Motunrayo321/AquaBot/20240624_151016.jpg

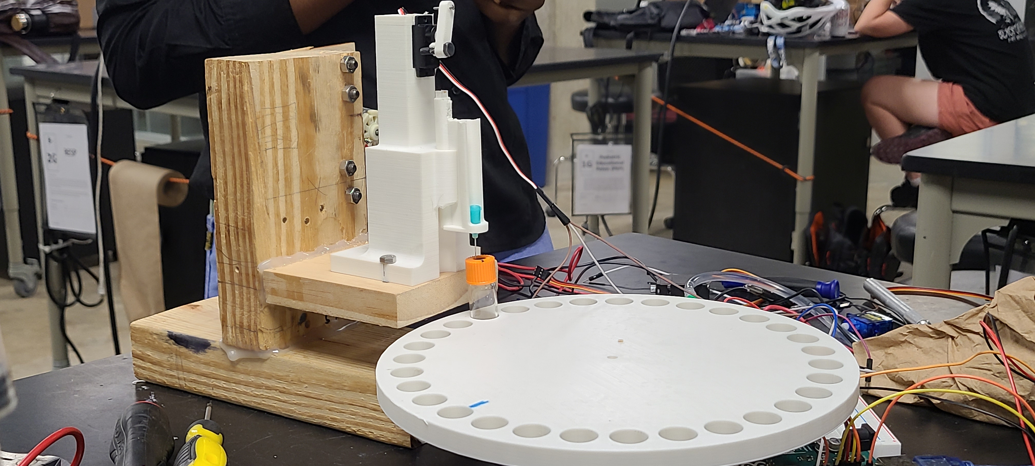
20240624_151016.jpg
