Motunrayo321/AquaBot/20240717_131111.jpg

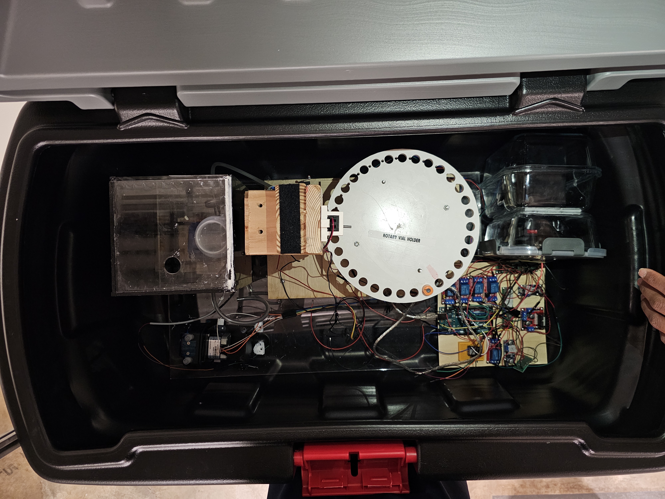
20240717_131111.jpg
