Motunrayo321/AquaBot/README.md

# Rotatory-Distribution-System

combined_tests: tests the combined action of the different components. The fullTest() function tests the entire operation of the system.

unit_tests: used to test the operation of individual components
