Motunrayo321/AquaBot/20240717_132358.jpg

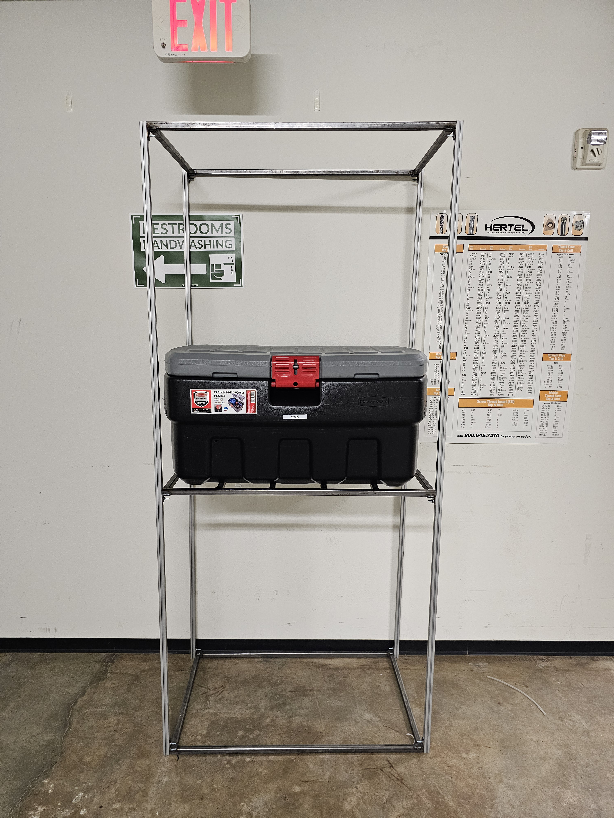
20240717_132358.jpg
