Motunrayo321/AquaBot/20240717_143332.jpg

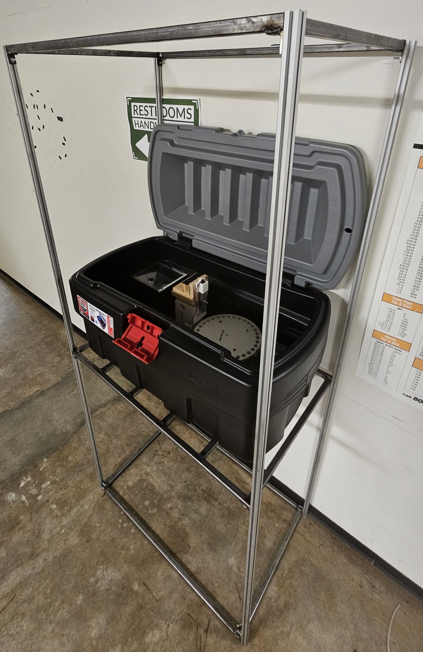
20240717_143332.jpg
