Motunrayo321/AquaBot/river_sampler_pcb/pngs/back.png

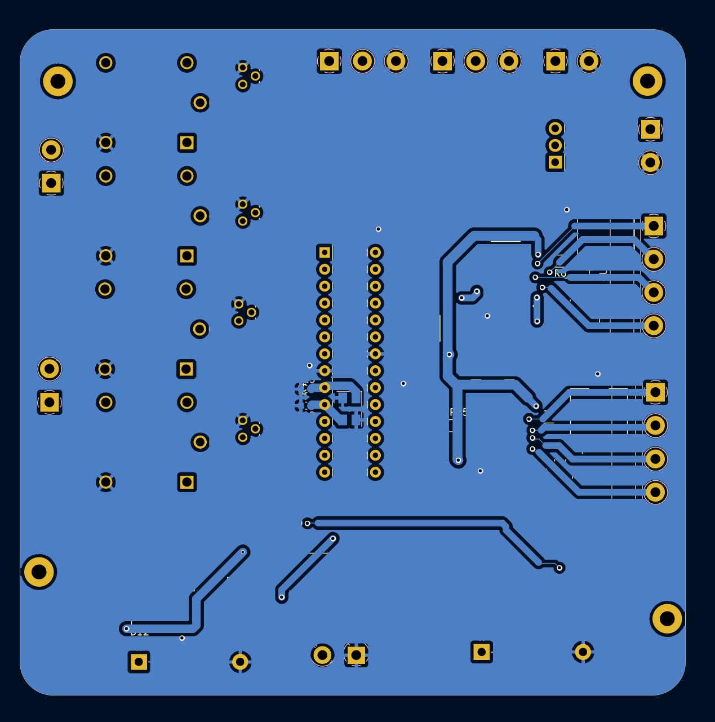
river_sampler_pcb/pngs/back.png
