Motunrayo321/AquaBot/river_sampler_pcb/pngs/front.png

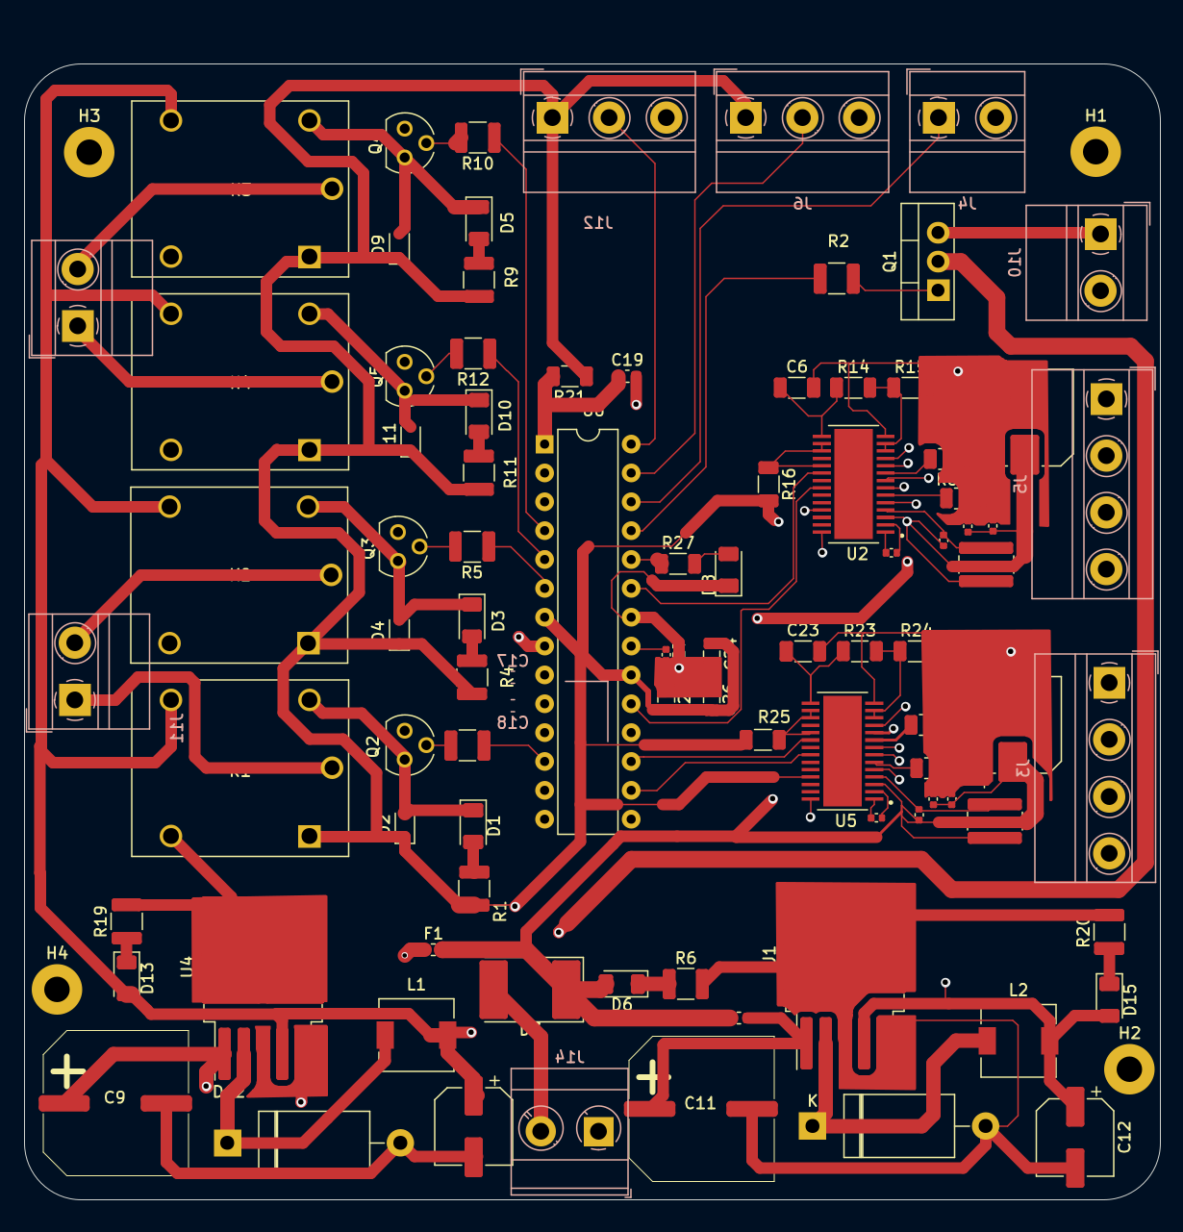
river_sampler_pcb/pngs/front.png
