Motunrayo321/AquaBot/river_sampler_pcb/pngs/river_sampler-Distribution System-5V relay3.png

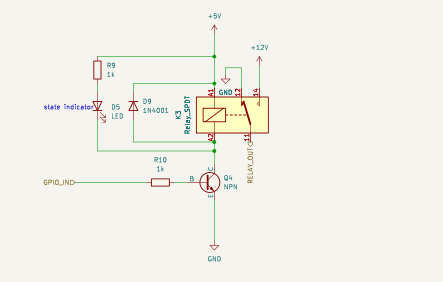
river_sampler_pcb/pngs/river_sampler-Distribution System-5V relay3.png
