Motunrayo321/AquaBot/river_sampler_pcb/pngs/river_sampler-Distribution System-drv8825 driver1.png

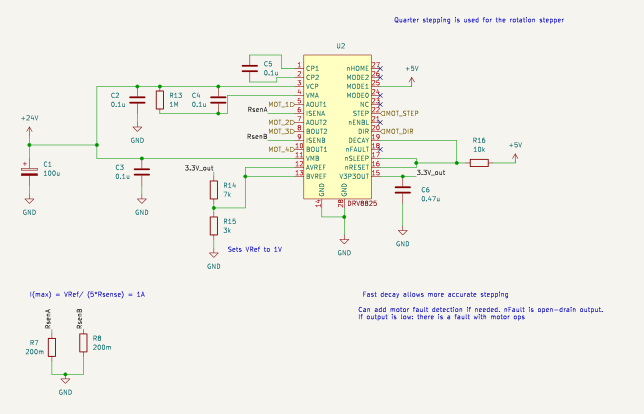
river_sampler_pcb/pngs/river_sampler-Distribution System-drv8825 driver1.png
