Motunrayo321/AquaBot/river_sampler_pcb/pngs/river_sampler-Distribution System.png

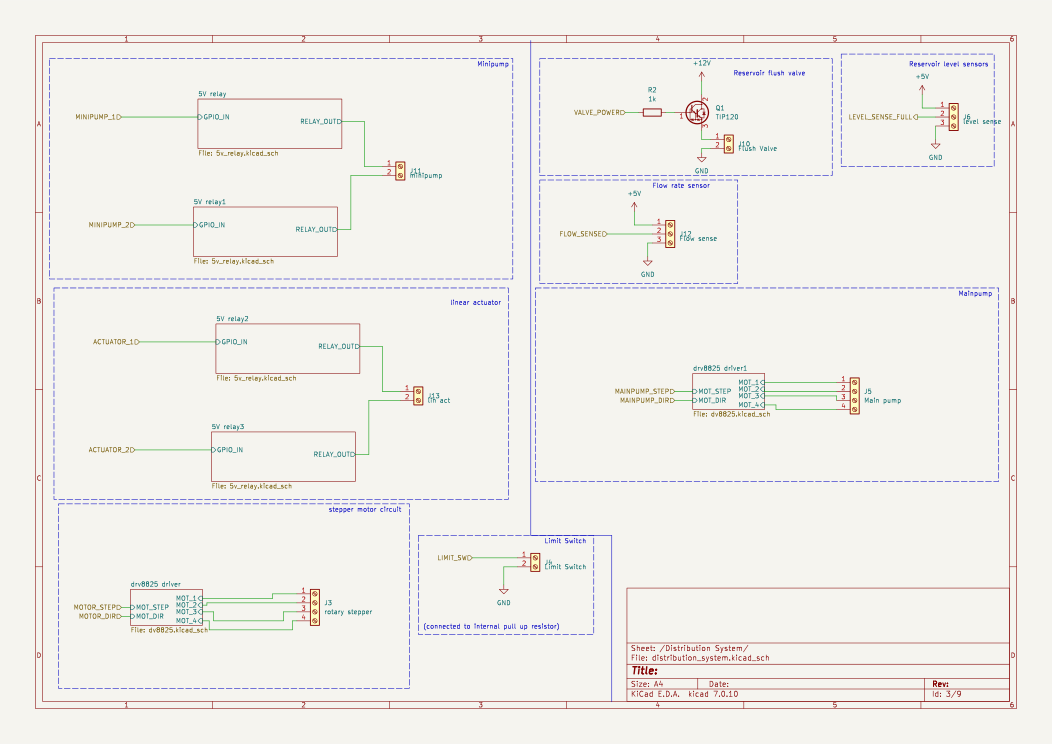
river_sampler_pcb/pngs/river_sampler-Distribution System.png
