Motunrayo321/AquaBot/river_sampler_pcb/pngs/river_sampler-power supply.png

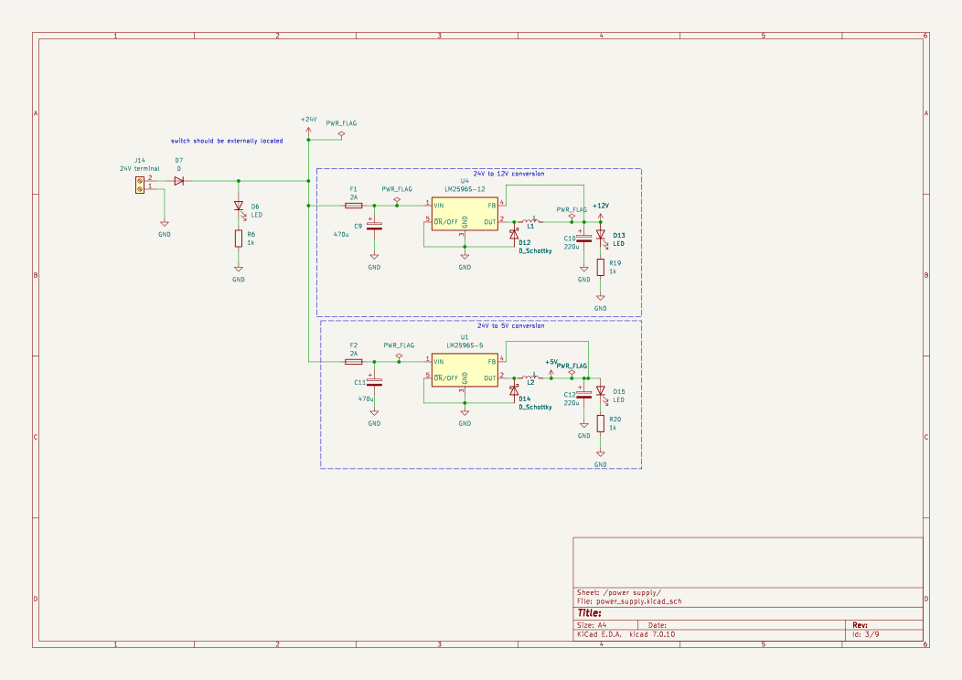
river_sampler_pcb/pngs/river_sampler-power supply.png
