Motunrayo321/AquaBot/river_sampler_pcb/pngs/river_sampler.png

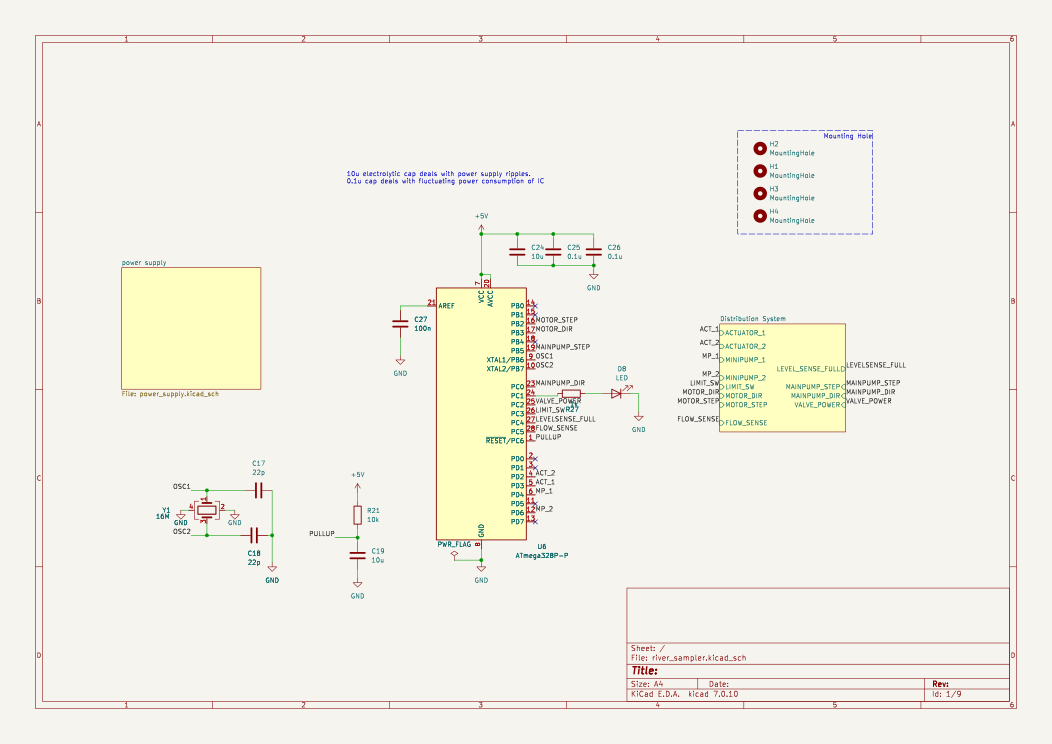
river_sampler_pcb/pngs/river_sampler.png
