Motunrayo321/AquaBot/main_schematic.pdf

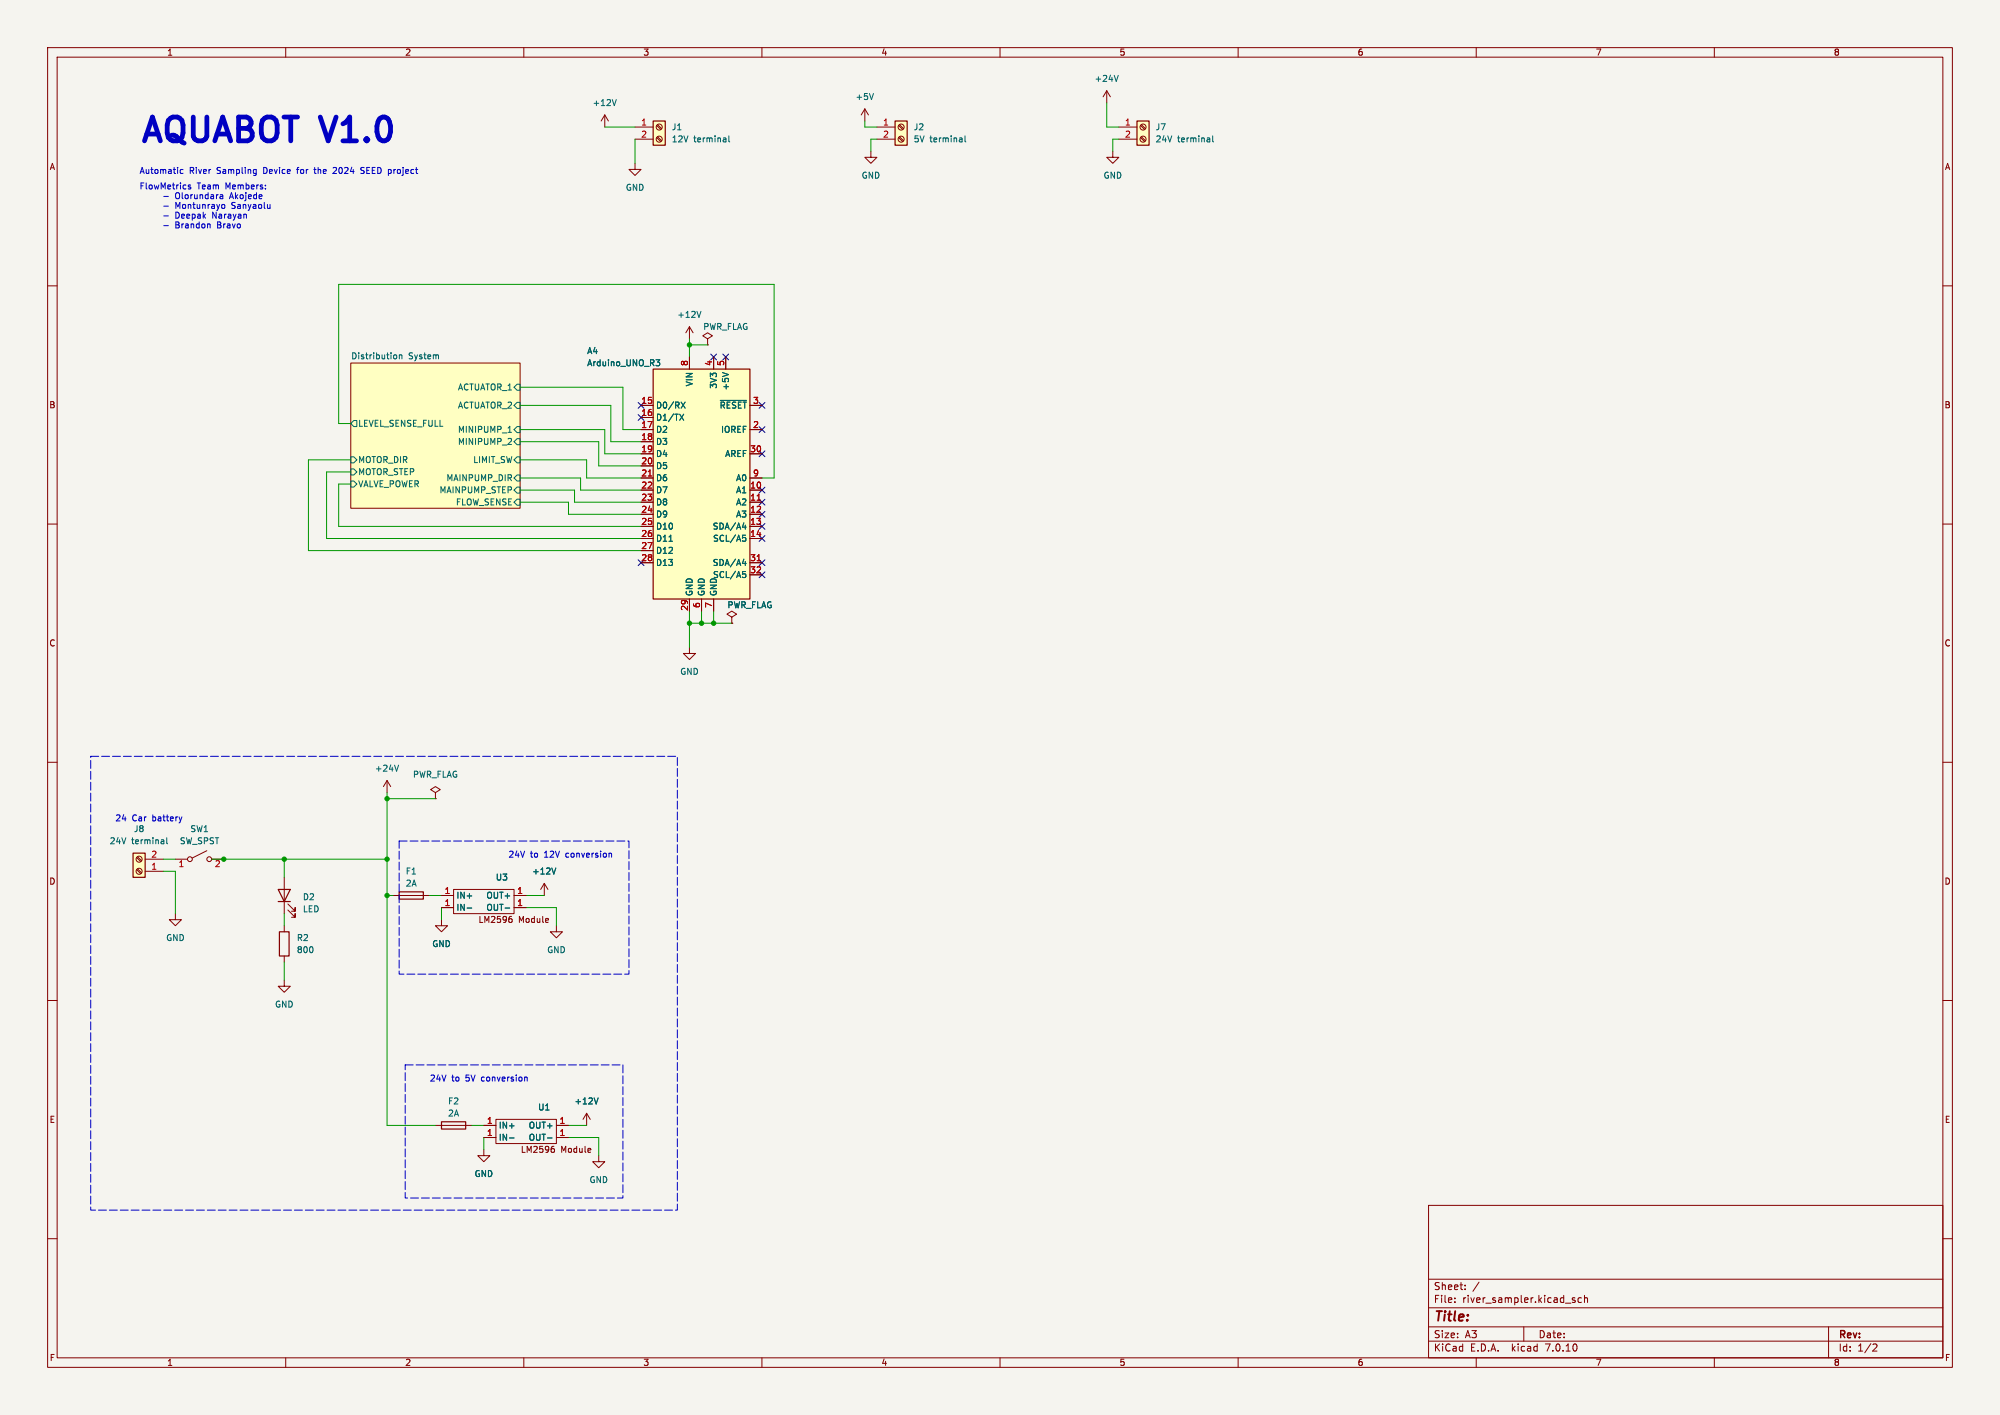
[picture p12: page 1]

Id: 1/2 Title: File: river_sampler.kicad_sch Sheet: /

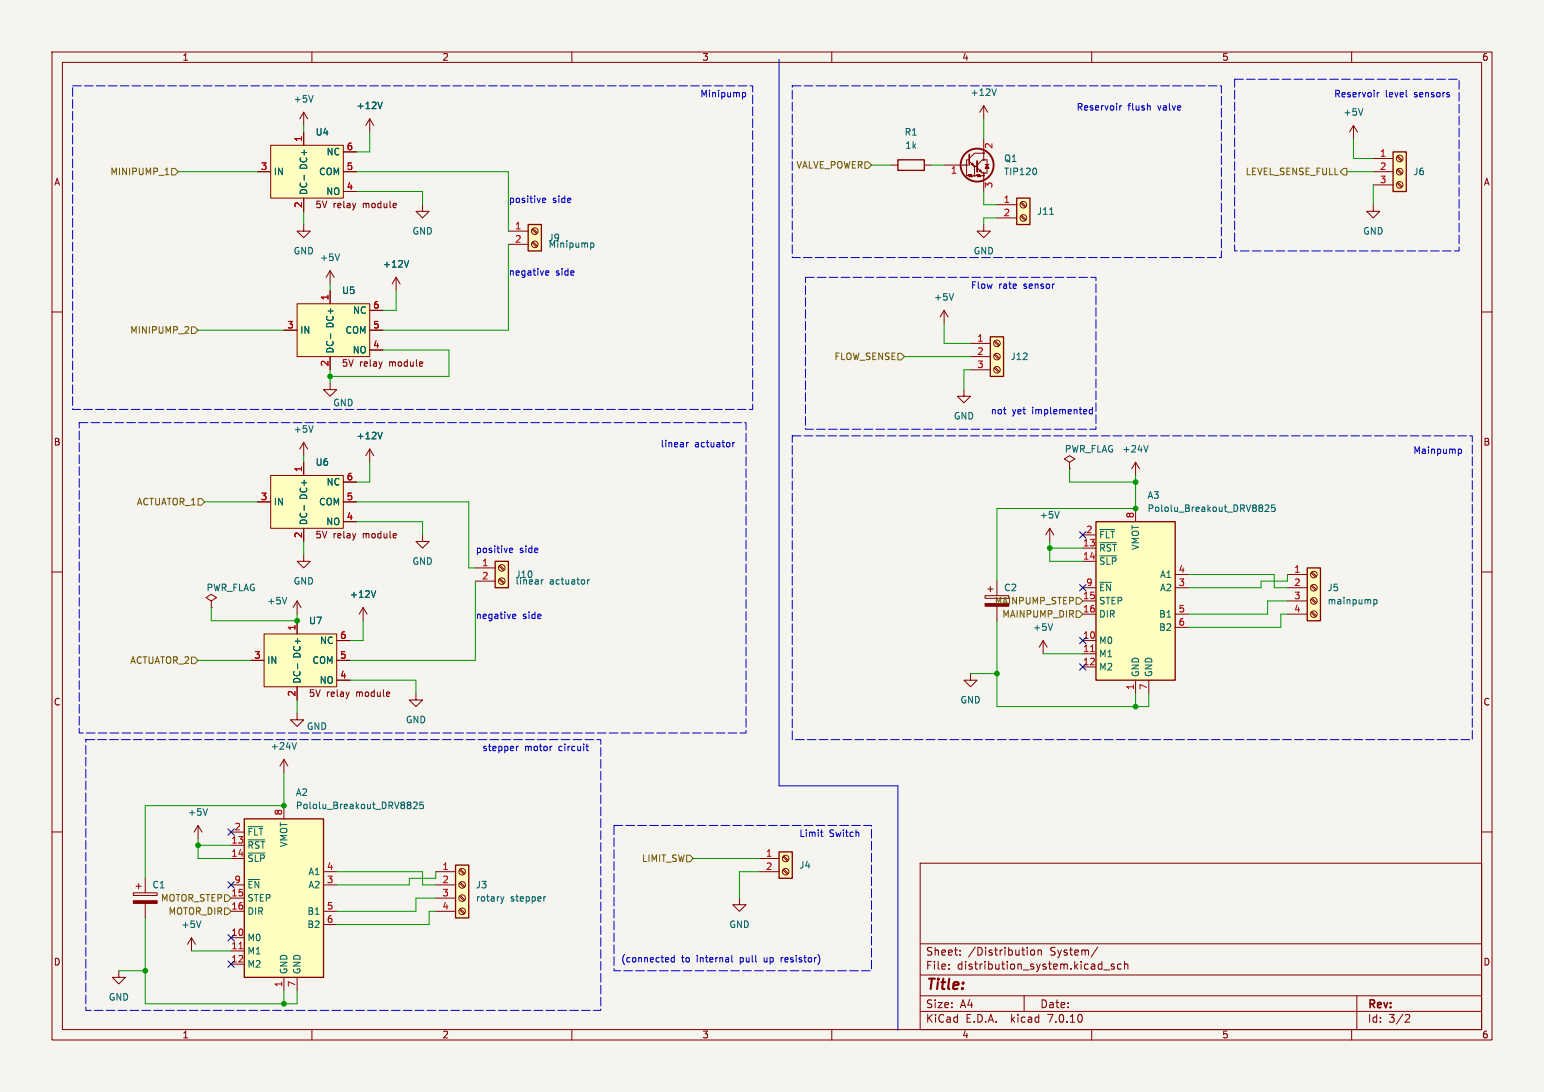
[picture p13: page 2]

Reservoir level sensors Mainpump

linear actuator stepper motor circuit

1 M0 10 M1 11 M2 12 ~{RST} 13 ~{SLP} 14 STEP 15 DIR 16 ~{FLT} 2 A2 3 A1 4 B1 5 B2 6 GND
