Motunrayo321/AquaBot/river_sampler_pcb/river_sampler.kicad_pcb

## KiCad design river_sampler_pcb/river_sampler.kicad_pcb (2024-08-08)

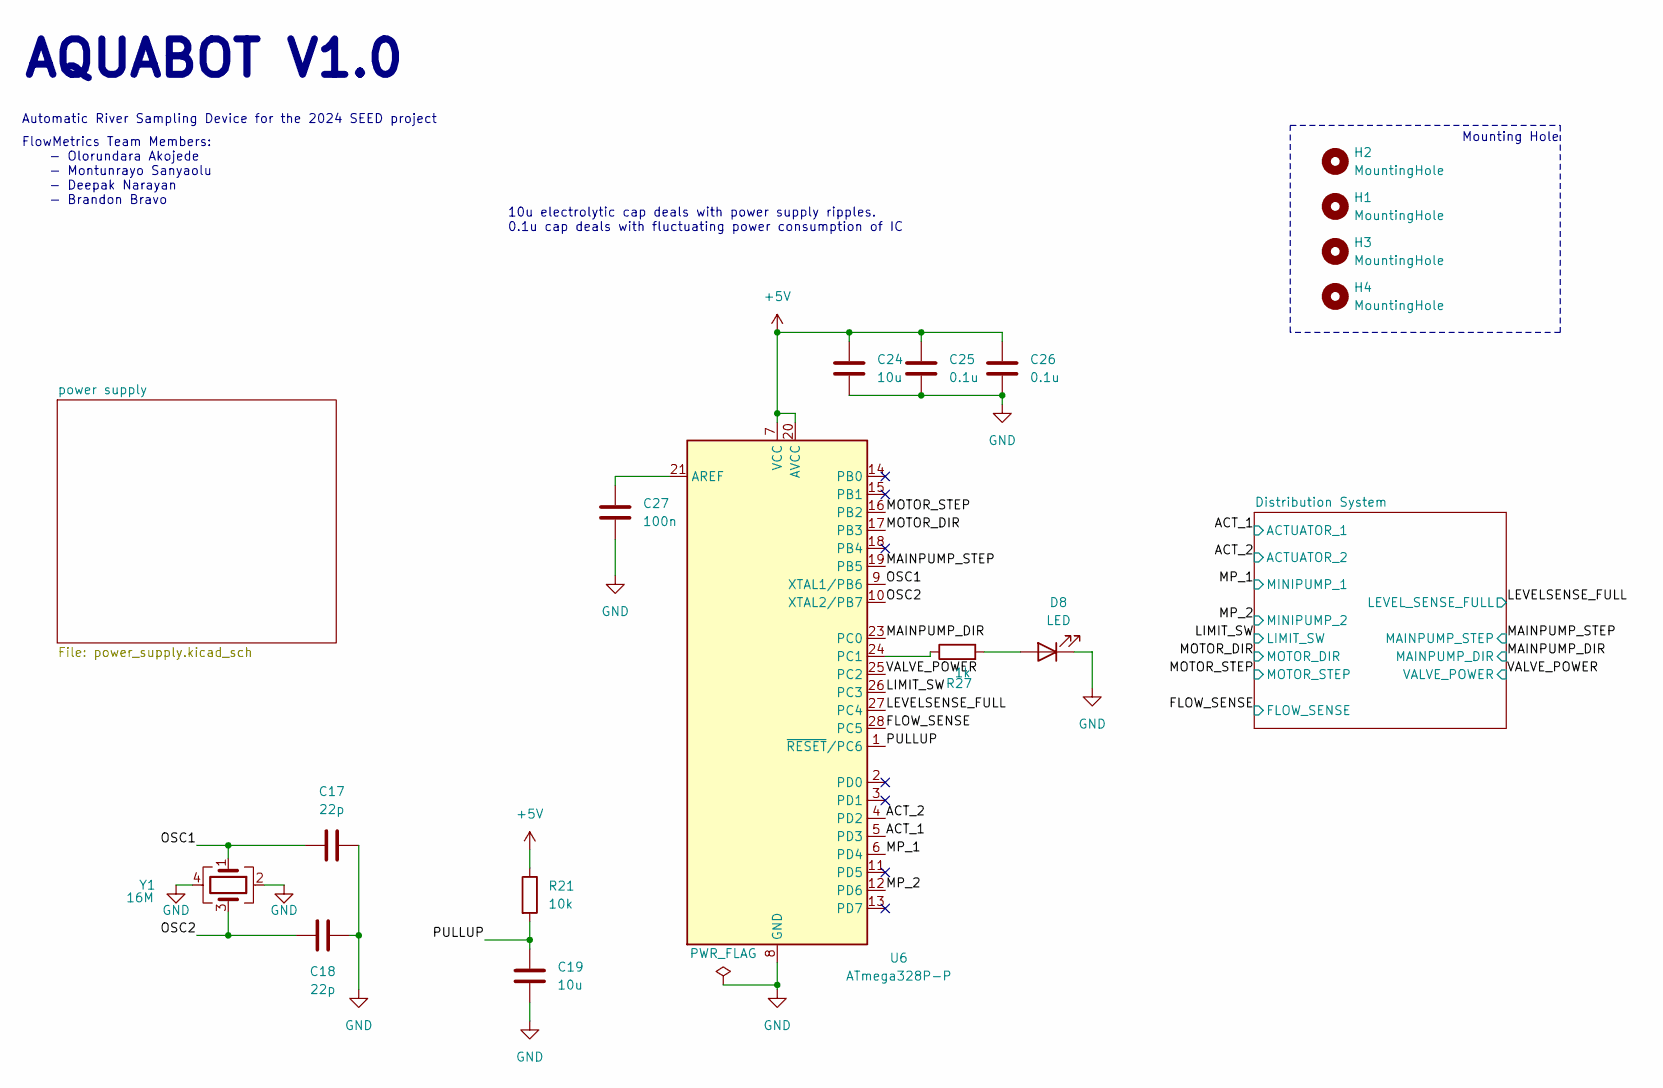
[picture p14: schematic river_sampler.kicad_sch]

Parts:
C17, C18: 22p; C_0603_1608Metric
C19: 10u; C_0603_1608Metric
C24: 10u; C_0805_2012Metric
C25, C26: 0.1u; C_0805_2012Metric
C27: 100n; C_0402_1005Metric
D8: LED; LED_1206_3216Metric
H1, H2, H3, H4: MountingHole; MountingHole_2.2mm_M2_Pad
R21: 10k; R_1206_3216Metric
R27: 1k; R_1206_3216Metric
U6: ATmega328P-P; DIP-28_W7.62mm
Y1: 16M; Crystal_SMD_5032-4Pin_5.0x3.2mm

Connections:
+5V: C24.1, C25.1, C26.1, R21.1, U6.7 (VCC), U6.20 (AVCC); also elsewhere on the board
/ACT_1: U6.5 (PD3); also elsewhere on the board
/ACT_2: U6.4 (PD2); also elsewhere on the board
/FLOW_SENSE: U6.28 (PC5); also elsewhere on the board
/LEVELSENSE_FULL: U6.27 (PC4); also elsewhere on the board
/LIMIT_SW: U6.26 (PC3); also elsewhere on the board
/MAINPUMP_DIR: U6.23 (PC0); also elsewhere on the board
/MAINPUMP_STEP: U6.19 (PB5); also elsewhere on the board
/MOTOR_DIR: U6.17 (PB3); also elsewhere on the board
/MOTOR_STEP: U6.16 (PB2); also elsewhere on the board
/MP_1: U6.6 (PD4); also elsewhere on the board
/MP_2: U6.12 (PD6); also elsewhere on the board
/OSC1: C17.1, U6.9 (XTAL1/PB6), Y1.1
/OSC2: C18.1, U6.10 (XTAL2/PB7), Y1.3
/PULLUP: C19.1, R21.2, U6.1 (~RESET/PC6)
/VALVE_POWER: U6.25 (PC2); also elsewhere on the board
GND: C17.2, C18.2, C19.2, C24.2, C25.2, C26.2, C27.2, D8.1 (K), U6.8 (GND), U6.22 (GND), Y1.2, Y1.4; also elsewhere on the board
unnamed: D8.2 (A), R27.2
unnamed: C27.1, U6.21 (AREF)
unnamed: R27.1, U6.24 (PC1)

Notes on the sheet:
AQUABOT V1.0
10u electrolytic cap deals with power supply ripples. 0.1u cap deals with fluctuating power consumption of IC
FlowMetrics Team Members: - Olorundara Akojede - Montunrayo Sanyaolu - Deepak Narayan - Brandon Bravo
Automatic River Sampling Device for the 2024 SEED project
Mounting Hole

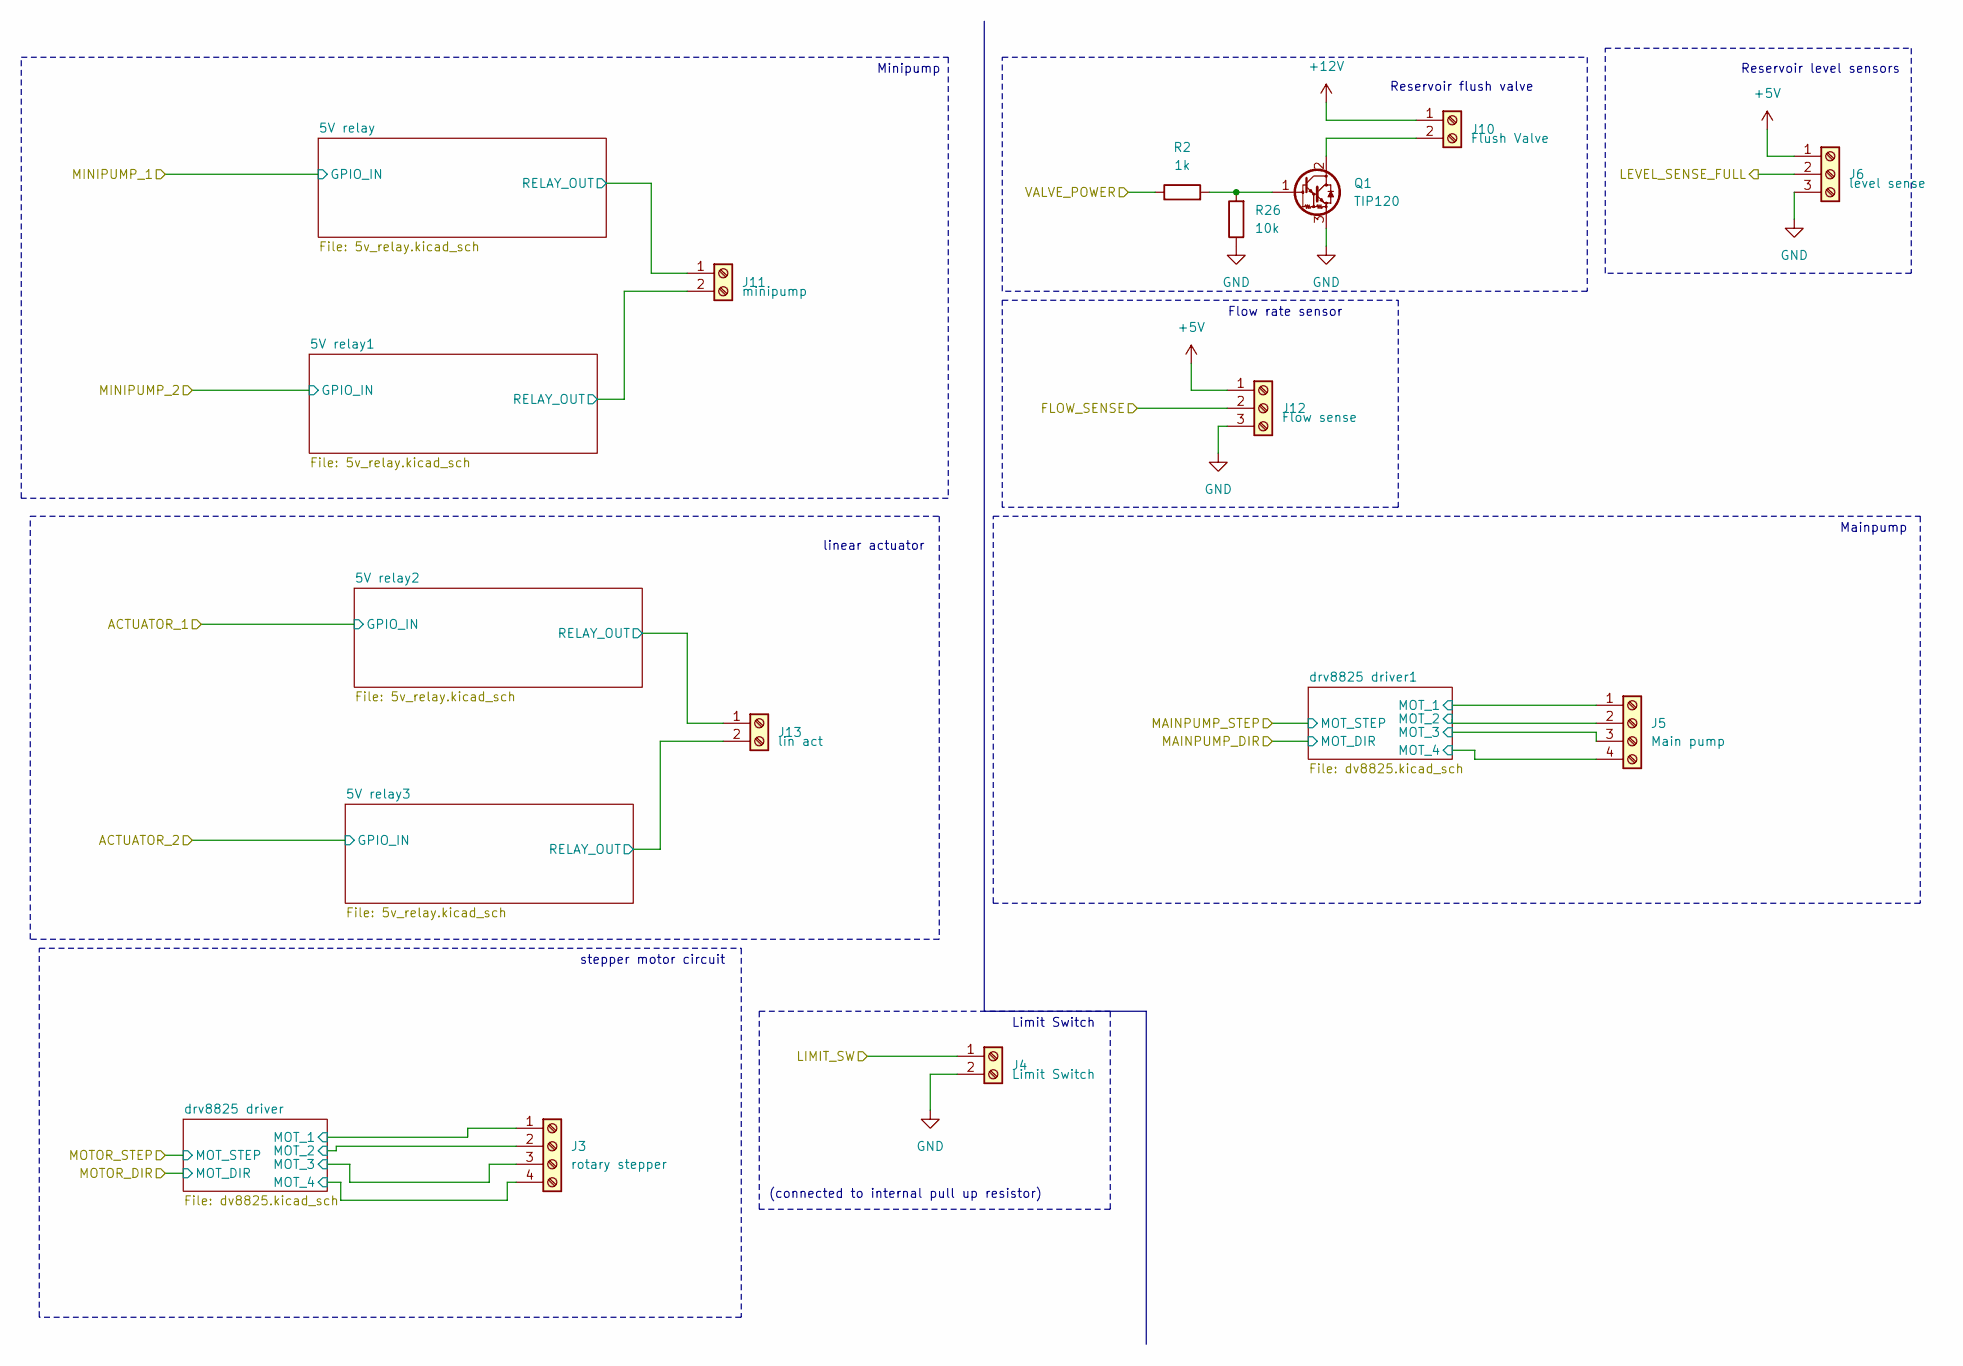
[picture p15: schematic distribution_system.kicad_sch]

Parts:
J3: rotary stepper; TerminalBlock_MetzConnect_Type011_RT05504HBWC_1x04_P5.00mm_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
J4: Limit Switch; TerminalBlock_MetzConnect_Type011_RT05502HBWC_1x02_P5.00mm_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
J5: Main pump; TerminalBlock_MetzConnect_Type011_RT05504HBWC_1x04_P5.00mm_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
J6: level sense; TerminalBlock_MetzConnect_Type011_RT05503HBWC_1x03_P5.00mm_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
J10: Flush Valve; TerminalBlock_MetzConnect_Type011_RT05502HBWC_1x02_P5.00mm_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
J11: minipump; TerminalBlock_MetzConnect_Type011_RT05502HBWC_1x02_P5.00mm_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
J12: Flow sense; TerminalBlock_MetzConnect_Type011_RT05503HBWC_1x03_P5.00mm_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
J13: lin act; TerminalBlock_MetzConnect_Type011_RT05502HBWC_1x02_P5.00mm_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
Q1: TIP120; TO-220-3_Vertical
R2: 1k; R_1210_3225Metric
R26: 10k; R_1210_3225Metric

Connections:
+5V: J6.1, J12.1; also elsewhere on the board
+12V: J10.1; also elsewhere on the board
/Distribution System/5V relay1/RELAY_OUT: J11.2; also elsewhere on the board
/Distribution System/5V relay2/RELAY_OUT: J13.1; also elsewhere on the board
/Distribution System/5V relay3/RELAY_OUT: J13.2; also elsewhere on the board
/Distribution System/5V relay/RELAY_OUT: J11.1; also elsewhere on the board
/Distribution System/drv8825 driver1/MOT_1: J5.1; also elsewhere on the board
/Distribution System/drv8825 driver1/MOT_2: J5.2; also elsewhere on the board
/Distribution System/drv8825 driver1/MOT_3: J5.3; also elsewhere on the board
/Distribution System/drv8825 driver1/MOT_4: J5.4; also elsewhere on the board
/Distribution System/drv8825 driver/MOT_1: J3.1; also elsewhere on the board
/Distribution System/drv8825 driver/MOT_2: J3.2; also elsewhere on the board
/Distribution System/drv8825 driver/MOT_3: J3.3; also elsewhere on the board
/Distribution System/drv8825 driver/MOT_4: J3.4; also elsewhere on the board
/FLOW_SENSE: J12.2; also elsewhere on the board
/LEVELSENSE_FULL: J6.2; also elsewhere on the board
/LIMIT_SW: J4.1; also elsewhere on the board
/VALVE_POWER: R2.1; also elsewhere on the board
GND: J4.2, J6.3, J12.3, Q1.3 (E), R26.1; also elsewhere on the board
unnamed: J10.2, Q1.2 (C)
unnamed: Q1.1 (B), R2.2, R26.2

Notes on the sheet:
Reservoir level sensors
Limit Switch
Mainpump
Minipump
stepper motor circuit
Flow rate sensor
Reservoir flush valve
linear actuator
(connected to internal pull up resistor)

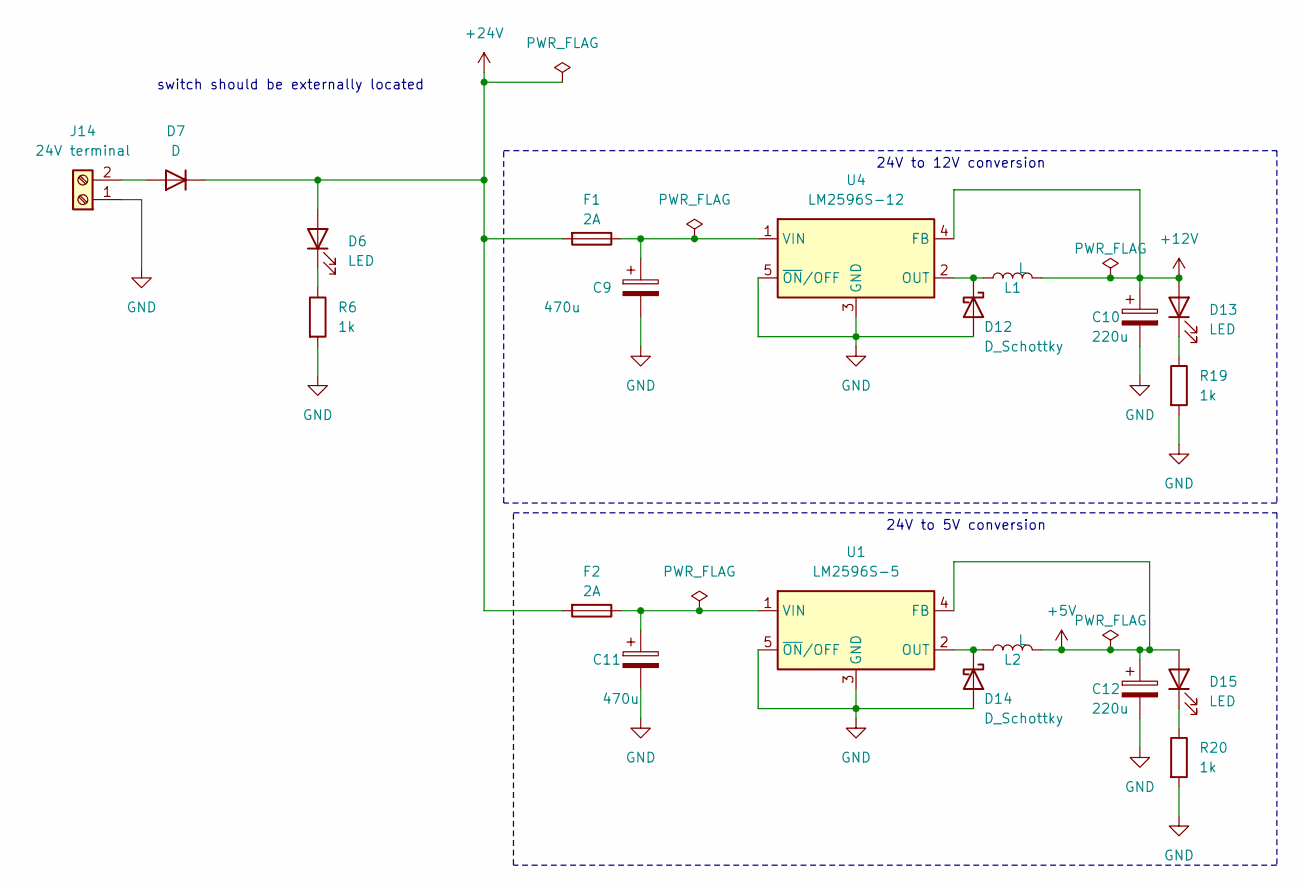
[picture p16: schematic power_supply.kicad_sch]

Parts:
C9, C11: 470u; C_SMD_470uF_12.5Dx13.5L
C10, C12: 220u; CP_Elec_6.3x7.7
D6, D13, D15: LED; LED_1206_3216Metric
D7: D; D_3220_8050Metric
D12, D14: D_Schottky; D_DO-27_P15.24mm_Horizontal
F1, F2: 2A; Fuse_0603_1608Metric
J14: 24V terminal; TerminalBlock_MetzConnect_Type073_RT02602HBLU_1x02_P5.08mm_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
L1, L2: L; L_6.3x6.3_H3
R6, R19, R20: 1k; R_1210_3225Metric
U1: LM2596S-5; TO-263-5_TabPin3
U4: LM2596S-12; TO-263-5_TabPin3

Connections:
+5V: C12.1, D15.2 (A), L2.2, U1.4 (FB); also elsewhere on the board
+12V: C10.1, D13.2 (A), L1.2, U4.4 (FB); also elsewhere on the board
+24V: D6.2 (A), D7.1 (K), F1.2, F2.2; also elsewhere on the board
GND: C9.2, C10.2, C11.2, C12.2, D12.2 (A), D14.2 (A), J14.1, R6.2, R19.2, R20.2, U1.3 (GND), U1.5 (~ON/OFF), U4.3 (GND), U4.5 (~ON/OFF); also elsewhere on the board
unnamed: D6.1 (K), R6.1
unnamed: D7.2 (A), J14.2
unnamed: D12.1 (K), L1.1, U4.2 (OUT)
unnamed: D13.1 (K), R19.1
unnamed: D14.1 (K), L2.1, U1.2 (OUT)
unnamed: D15.1 (K), R20.1
unnamed: C11.1, F2.1, U1.1 (VIN)
unnamed: C9.1, F1.1, U4.1 (VIN)

Notes on the sheet:
24V to 5V conversion
24V to 12V conversion
switch should be externally located

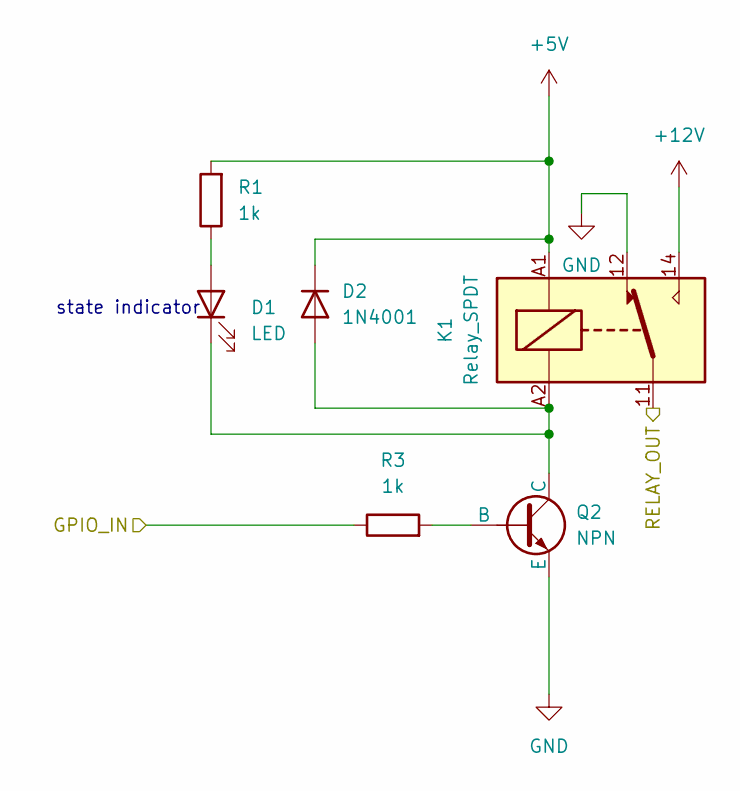
[picture p17: schematic 5v_relay.kicad_sch]

Parts:
D1: LED; LED_1206_3216Metric
D2: 1N4001; D_SOD-323
K1: Relay_SPDT; RELAY_SRD-05VDC-SL-C
Q2: NPN; TO92
R1, R3: 1k; R_1210_3225Metric

Connections:
+5V: D2.1 (K), K1.A1, R1.2; also elsewhere on the board
+12V: K1.14; also elsewhere on the board
/Distribution System/5V relay1/RELAY_OUT: K1.11; also elsewhere on the board
/MP_2: R3.1; also elsewhere on the board
GND: K1.12, Q2.3 (E); also elsewhere on the board
unnamed: D1.2 (A), R1.1
unnamed: D1.1 (K), D2.2 (A), K1.A2, Q2.1 (C)
unnamed: Q2.2 (B), R3.2

Parts of its further copies:
D3, D5, D10: LED; LED_1206_3216Metric
D4, D9, D11: 1N4001; D_SOD-323
K2, K3, K4: Relay_SPDT; RELAY_SRD-05VDC-SL-C
Q3, Q4, Q5: NPN; TO92
R4, R5, R9, R10, R11, R12: 1k; R_1210_3225Metric

Connections of its further copies:
+5V: D4.1 (K), D9.1 (K), D11.1 (K), K2.A1, K3.A1, K4.A1, R4.2, R9.2, R11.2; also elsewhere on the board
+12V: K2.14, K3.14, K4.14; also elsewhere on the board
/ACT_1: R12.1; also elsewhere on the board
/ACT_2: R10.1; also elsewhere on the board
/Distribution System/5V relay2/RELAY_OUT: K4.11; also elsewhere on the board
/Distribution System/5V relay3/RELAY_OUT: K3.11; also elsewhere on the board
/Distribution System/5V relay/RELAY_OUT: K2.11; also elsewhere on the board
/MP_1: R5.1; also elsewhere on the board
GND: K2.12, K3.12, K4.12, Q3.3 (E), Q4.3 (E), Q5.3 (E); also elsewhere on the board
unnamed: D3.2 (A), R4.1
unnamed: D3.1 (K), D4.2 (A), K2.A2, Q3.1 (C)
unnamed: D5.2 (A), R9.1
unnamed: D5.1 (K), D9.2 (A), K3.A2, Q4.1 (C)
unnamed: D10.2 (A), R11.1
unnamed: D10.1 (K), D11.2 (A), K4.A2, Q5.1 (C)
unnamed: Q3.2 (B), R5.2
unnamed: Q4.2 (B), R10.2
unnamed: Q5.2 (B), R12.2

Notes on the sheet:
state indicator

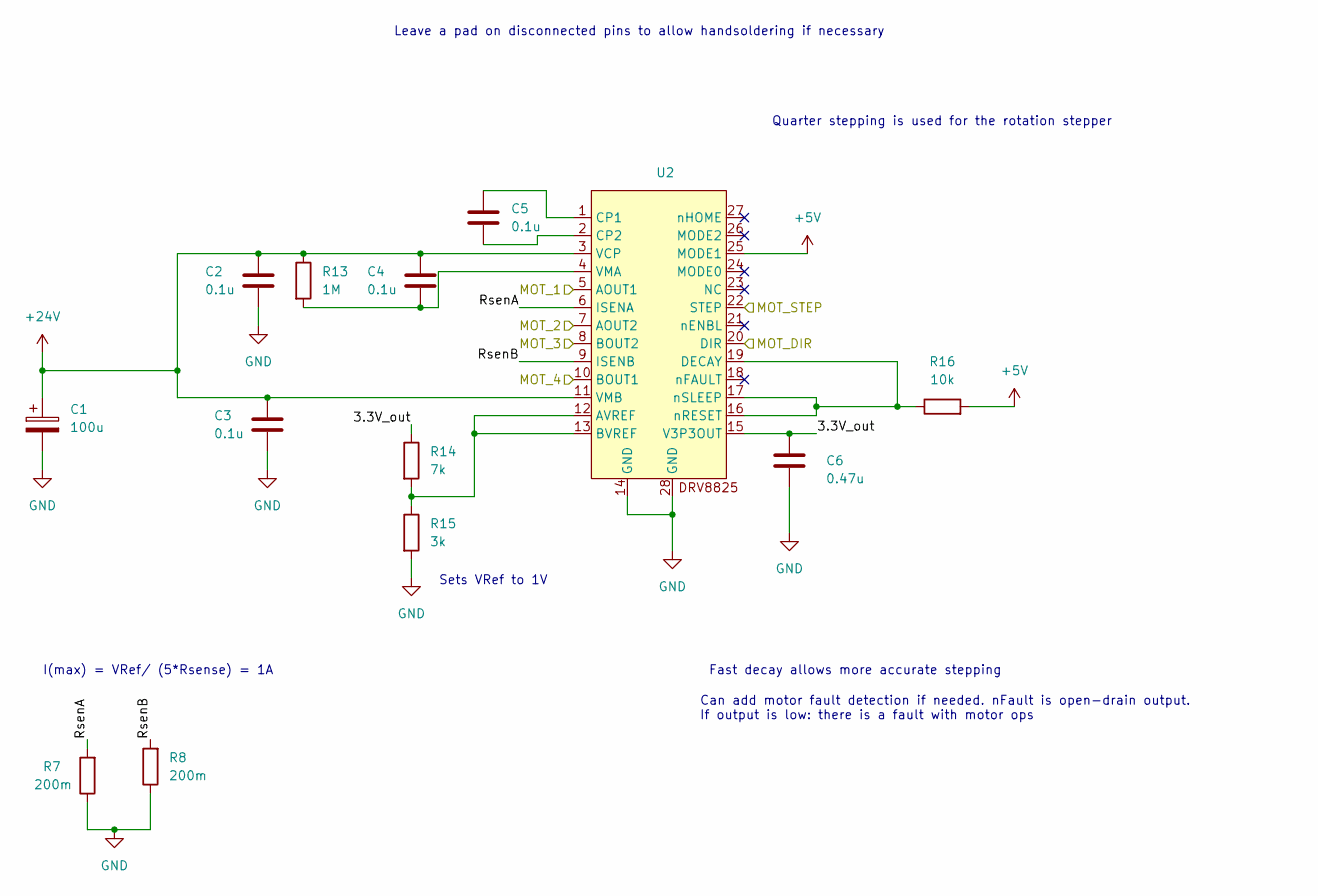
[picture p18: schematic dv8825.kicad_sch]

Parts:
C1: 100u; CP_Elec_8x10
C2, C3, C4, C5: 0.1u; C_0402_1005Metric
C6: 0.47u; C_1206_3216Metric
R7, R8: 200m; R_1206_3216Metric
R13: 1M; R_1218_3246Metric
R14: 7k; R_1206_3216Metric
R15: 3k; R_1206_3216Metric
R16: 10k; R_1206_3216Metric
U2: IC_TPS61196PWPRQ1

Connections:
+5V: R16.2, U2.25 (MODE1); also elsewhere on the board
+24V: C1.1, C2.1, C3.1, C4.1, R13.1, U2.3 (VCP), U2.11 (VMB); also elsewhere on the board
/Distribution System/drv8825 driver1/3.3V_out: C6.1, R14.1, U2.15 (V3P3OUT)
/Distribution System/drv8825 driver1/MOT_1: U2.5 (AOUT1); also elsewhere on the board
/Distribution System/drv8825 driver1/MOT_2: U2.7 (AOUT2); also elsewhere on the board
/Distribution System/drv8825 driver1/MOT_3: U2.8 (BOUT2); also elsewhere on the board
/Distribution System/drv8825 driver1/MOT_4: U2.10 (BOUT1); also elsewhere on the board
/Distribution System/drv8825 driver1/RsenA: R7.2, U2.6 (ISENA)
/Distribution System/drv8825 driver1/RsenB: R8.2, U2.9 (ISENB)
/MAINPUMP_DIR: U2.20 (DIR); also elsewhere on the board
/MAINPUMP_STEP: U2.22 (STEP); also elsewhere on the board
GND: C1.2, C2.2, C3.2, C6.2, R7.1, R8.1, R15.2, U2.14 (GND), U2.28 (GND); also elsewhere on the board
unnamed: R14.2, R15.1, U2.12 (AVREF), U2.13 (BVREF)
unnamed: C5.1, U2.1 (CP1)
unnamed: C5.2, U2.2 (CP2)
unnamed: R16.1, U2.16 (nRESET), U2.17 (nSLEEP), U2.19 (DECAY)
unnamed: C4.2, R13.2, U2.4 (VMA)

Parts of its further copies:
C7: 100u; CP_Elec_8x10
C8, C20, C21, C22: 0.1u; C_0402_1005Metric
C23: 0.47u; C_1206_3216Metric
R17, R18: 200m; R_1206_3216Metric
R22: 1M; R_1218_3246Metric
R23: 7k; R_1206_3216Metric
R24: 3k; R_1206_3216Metric
R25: 10k; R_1206_3216Metric
U5: IC_TPS61196PWPRQ1

Connections of its further copies:
+5V: R25.2, U5.25 (MODE1); also elsewhere on the board
+24V: C7.1, C8.1, C20.1, C21.1, R22.1, U5.3 (VCP), U5.11 (VMB); also elsewhere on the board
/Distribution System/drv8825 driver/3.3V_out: C23.1, R23.1, U5.15 (V3P3OUT)
/Distribution System/drv8825 driver/MOT_1: U5.5 (AOUT1); also elsewhere on the board
/Distribution System/drv8825 driver/MOT_2: U5.7 (AOUT2); also elsewhere on the board
/Distribution System/drv8825 driver/MOT_3: U5.8 (BOUT2); also elsewhere on the board
/Distribution System/drv8825 driver/MOT_4: U5.10 (BOUT1); also elsewhere on the board
/Distribution System/drv8825 driver/RsenA: R17.2, U5.6 (ISENA)
/Distribution System/drv8825 driver/RsenB: R18.2, U5.9 (ISENB)
/MOTOR_DIR: U5.20 (DIR); also elsewhere on the board
/MOTOR_STEP: U5.22 (STEP); also elsewhere on the board
GND: C7.2, C8.2, C20.2, C23.2, R17.1, R18.1, R24.2, U5.14 (GND), U5.28 (GND); also elsewhere on the board
unnamed: R23.2, R24.1, U5.12 (AVREF), U5.13 (BVREF)
unnamed: C22.1, U5.1 (CP1)
unnamed: C22.2, U5.2 (CP2)
unnamed: R25.1, U5.16 (nRESET), U5.17 (nSLEEP), U5.19 (DECAY)
unnamed: C21.2, R22.2, U5.4 (VMA)

Notes on the sheet:
Leave a pad on disconnected pins to allow handsoldering if necessary
Sets VRef to 1V
Fast decay allows more accurate stepping
Can add motor fault detection if needed. nFault is open-drain output. If output is low: there is a fault with motor ops
Quarter stepping is used for the rotation stepper
I(max) = VRef/ (5*Rsense) = 1A

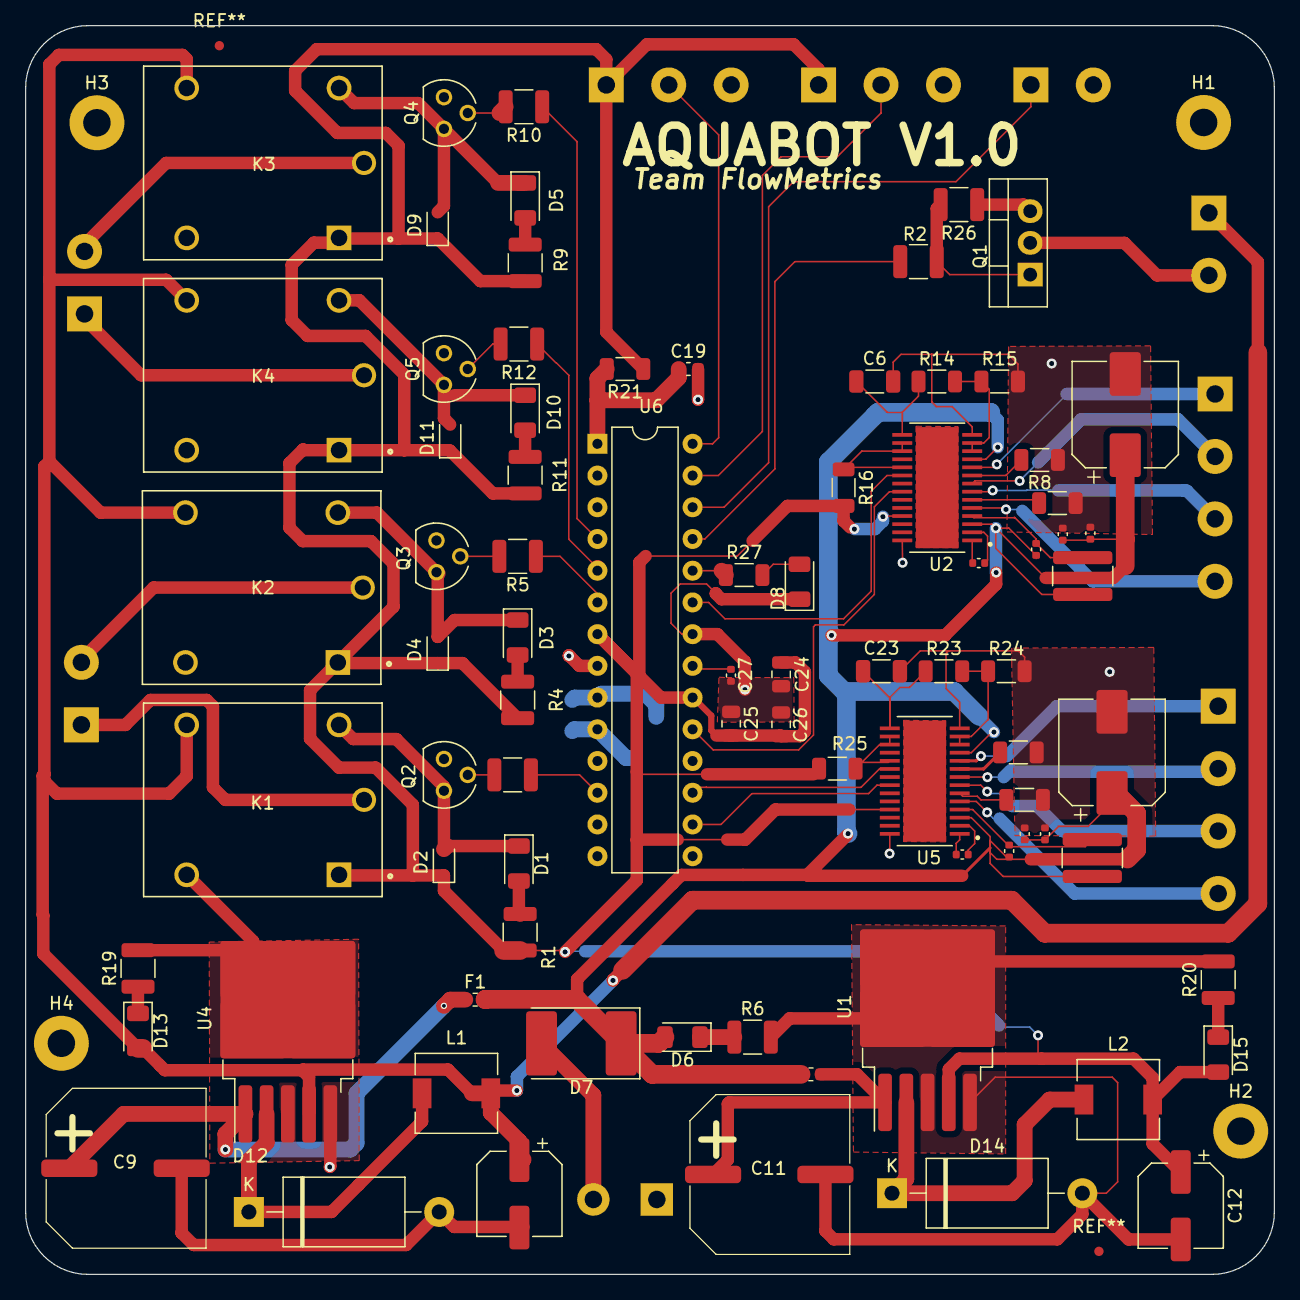
[picture p19: board river_sampler.kicad_pcb from above]

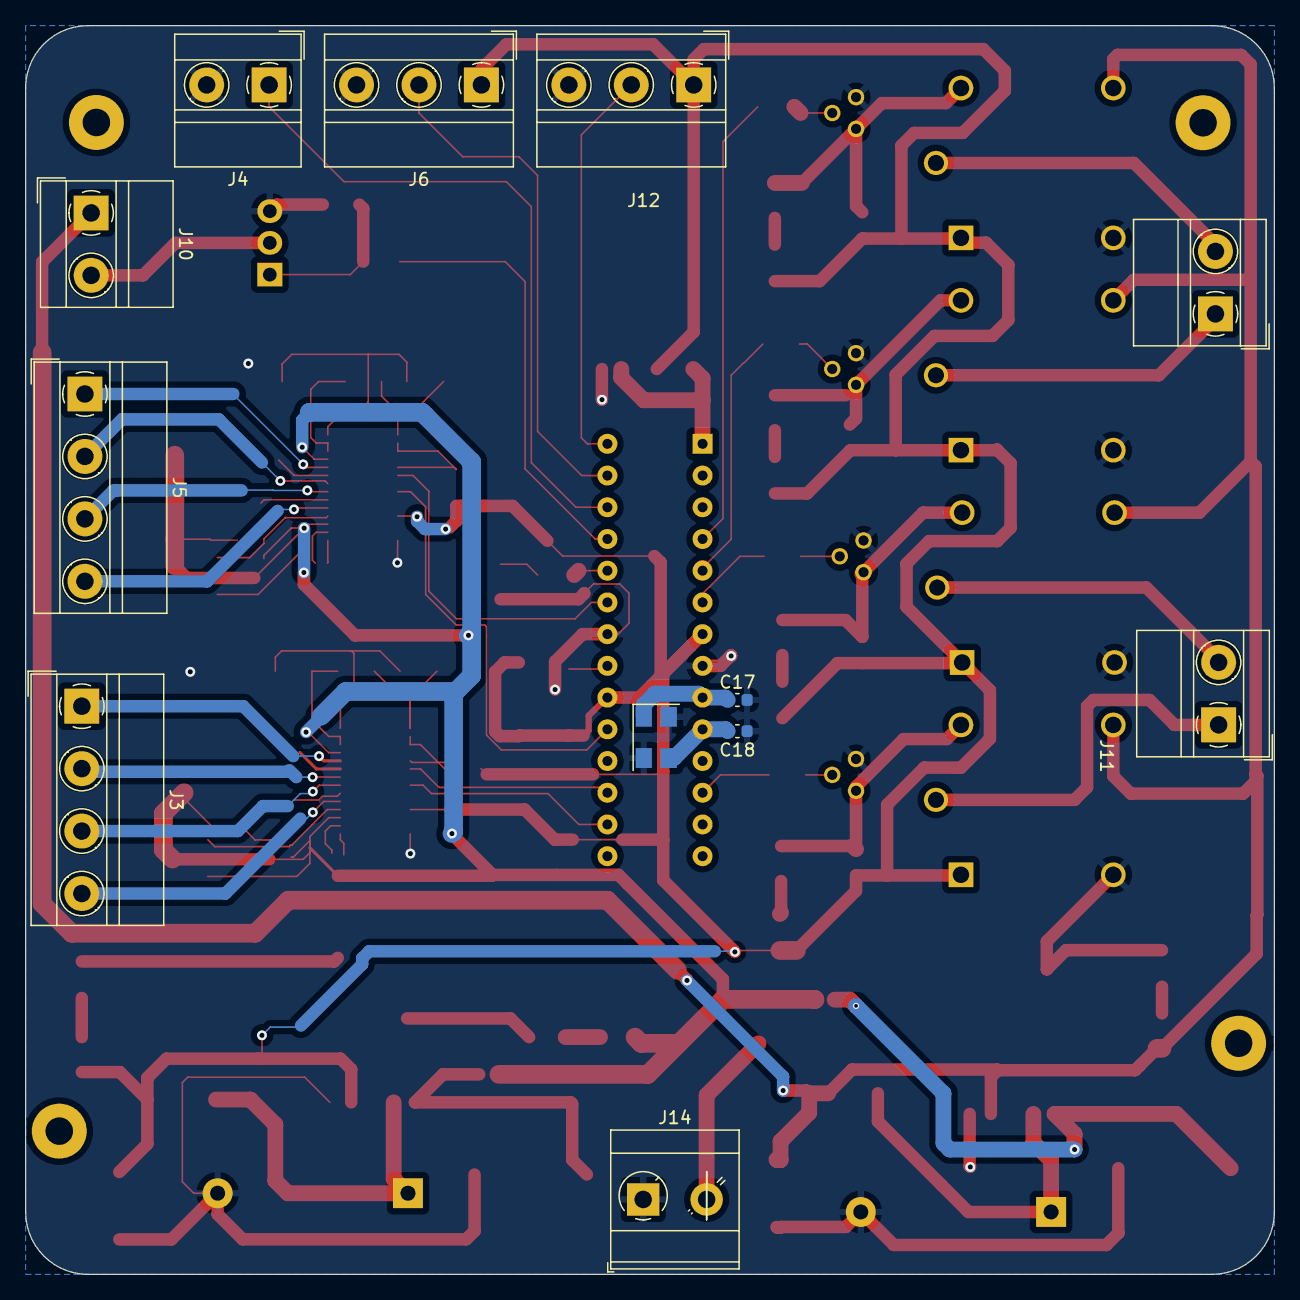
[picture p20: board river_sampler.kicad_pcb from below]

Board: 2 copper layers, 100.0 x 100.0 mm, 97 parts (12 on the bottom side), 72 nets.
