Motunrayo321/AquaBot/combined_tests/combined_tests.ino

/*
Tests the combined action of the rotaryDistribution System
*/
#include <Bonezegei_DRV8825.h>
#include <Stepper.h>

#define motorForward 1
#define motorReverse 0
#define motorDirPin 29
#define motorStepPin 27


#define limitSwitchPin 7
#define actuatorPin1 2
#define actuatorPin2 3
#define miniPumpPin1 4
#define miniPumpPin2 6

#define valvePowerPin 11
#define mainPumpDirPin 33
#define mainPumpStepPin 31





// Define the number of steps per revolution for your stepper motor
const int stepsPerRevRound = 800;
const int mainPumpStepsPerRevRound = 200;
const int vialCount = 32;

Bonezegei_DRV8825 stepperRound(motorDirPin, motorStepPin);
Bonezegei_DRV8825 mainPump(mainPumpDirPin, mainPumpStepPin);

// Controls how much the stepper has to rotate between vials
int stepsToRotate;
int stepsBetweenVials = round(stepsPerRevRound / vialCount);

const int totalDays = 31;
int bottlesFilled = 0;


const int flushLimit = 3;
int flushCount;

//tests the rotation of the servo to each vial position and the linear actuator motion for filling the vial
void actuatorStepperTest() {
  //int fsrHitCount = 0;
  while (bottlesFilled != totalDays) {
    //only rotates if the plate is at the home position
    while (!homeButtonHit()) {
      flushRun();
    }
    // Rotates the plate to the next vial position
    delay(3000);
    stepperRound.step(motorForward, stepsToRotate);
  
    Serial.println(stepsToRotate);

    Serial.print("At slot: ");
    Serial.println(bottlesFilled);
    delay(1000);

    //moves the actuator down to the filling position and back
    extendActuator();
    Serial.println("filling position");
    stopActuator();
    retractActuator();
    Serial.println("start position");
    delay(1000);

    bottlesFilled++;
    stepsToRotate = (stepsBetweenVials * (bottlesFilled + 1));
    //moves back to the starting slot
    flushRun();
    delay(1000);
    extendActuator();
    Serial.println("filling position");
    stopActuator();
    retractActuator();
    Serial.println("start position");
    delay(1000);

  }
}

//tests the servo stepper and mini pump operation to fill each vial
void fillVialTest() {
  while (bottlesFilled != totalDays) {
    //only rotates if the plate is at the home position
    while (!homeButtonHit()) {
      flushRun();
    }
    // Rotates the plate to the next vial position
    //delay(3000);
    stepperRound.step(motorForward, stepsToRotate);
    Serial.println(stepsToRotate);

    Serial.print("At slot: ");
    Serial.println(bottlesFilled);
    delay(1000);

    //moves the servo down to the filling position and back
    extendActuator();
    Serial.println("filling position");
    stopActuator();
    miniPumpControl();
    retractActuator();
    Serial.println("start position");
    delay(1000);

    bottlesFilled++;
    stepsToRotate = stepsBetweenVials * (bottlesFilled + 1);
    //moves back to the starting slot
    flushRun();
    delay(1000);
    extendActuator();
    Serial.println("filling position");
    stopActuator();
    retractActuator();
    Serial.println("start position");
    delay(1000);
  }
}

//combined test with flushing
void fullTest() {
  while (bottlesFilled != totalDays) {

    //flushes the system and cleans the filter before the filling the next vial
    flushSystem();

    //only rotates if the plate is at the home position
    while (!homeButtonHit()) {
      flushRun();
    }
    // Rotates the plate to the next vial position
    delay(3000);
    stepperRound.step(motorForward, stepsToRotate);
    Serial.println(stepsToRotate);

    Serial.print("At slot: ");
    Serial.println(bottlesFilled);
    delay(1000);

    //moves the servo down to the filling position and back
    extendActuator();
    Serial.println("filling position");
    stopActuator();
    miniPumpControl();
    retractActuator();
    Serial.println("start position");
    delay(1000);

    bottlesFilled++;
    stepsToRotate = stepsBetweenVials * (bottlesFilled + 1);
  }
}

//tests the flushing system and filter cleaning system
void flushSystem() {
  flushCount = 0;

  //Goes to the flushing slot
  Serial.println("Calling flushRun");
  flushRun();
  delay(2000);

  //lowers the nozzle to the flush tube
  Serial.println("Calling extendActuator");
  extendActuator();
  delay(2000);

  //cleans the filter by flushing water back and forth
  filterFlush();

  //flushes the reservoir 3 times
  while (flushCount != flushLimit) {
    Serial.print("Flush no.");
    Serial.println(flushCount + 1);
    Serial.print("Out of: ");
    Serial.println(flushLimit);
    delay(1000);

    //pumps water into the reservoir if there isn't enough water to flush the minipump 
    Serial.println("filling the reservoir");
    fillReservoir();
    //stopMainPump();

    //flushes the minipump
    miniPumpControl();

    //drains the reservoir until it is empty
    drainReservoir();
    flushCount++;

    delay(1000);
  }

  //flushing is done!
  retractActuator();
  delay(10000);
}


//activates the miniature pump to move water from the reservoir to the vial/flushing zone
void miniPumpControl() {
  //checks the volume of water drawn by the pump before activating it
  pumpForwards();
  Serial.println("Turning on the pump");
  delay(8000);
  stopPump();
  delay(1000);
  Serial.println("Turning off pump");
}

//activates main pump to fill the reservoir
void fillReservoir() {
  activateMainPump();
  Serial.println("reservoir full");
  //stopMainPump();
}
//drains the remaining water in the reservoir
void drainReservoir() {
  openValve();
  delay(5000);
  closeValve();
  delay(5000);
}

void extendActuator() {
  digitalWrite(actuatorPin1, HIGH);
  digitalWrite(actuatorPin2, LOW);
  Serial.println("extending actuator");
  delay(2500);
}
void stopActuator() {
  digitalWrite(actuatorPin1, LOW);
  digitalWrite(actuatorPin2, LOW);
  //NEED TO MODIFY BASED ON PUMP VOLUME
  delay(3000);
}

//retracts the actuator
void retractActuator() {
  digitalWrite(actuatorPin1, LOW);
  digitalWrite(actuatorPin2, HIGH);
  Serial.println("retracting actuator");
  delay(1900);
}


void activateMainPump() {
  int count = 0;
  mainPump.step(motorForward,5000);
  
}
void filterFlush() {
  Serial.println("Forward-flushing now");
  mainPump.step(motorForward,5000);
  delay(2000);
  Serial.println("Back-flushing now!");
  mainPump.step(motorReverse, 5000);
  delay(2000);

}
//turns off the main pump to stop filling the resrvoir
void stopMainPump() {
  digitalWrite(mainPumpDirPin, HIGH);
  digitalWrite(mainPumpStepPin, HIGH);
}

void pumpForwards() {
  digitalWrite(miniPumpPin1, HIGH);
  digitalWrite(miniPumpPin2, LOW);
}
void pumpBackwards() {
  digitalWrite(miniPumpPin1, HIGH);
  digitalWrite(miniPumpPin2, LOW);
}

void stopPump() {
  digitalWrite(miniPumpPin1, LOW);
  digitalWrite(miniPumpPin2, LOW);
}
void flushRun() {
  //rotates the stepper until the limit switch at the flushing slot is hit
  while (!homeButtonHit()) {
    stepperRound.step(motorReverse, 10);
    delay(50);
  }
}

void openValve() {
  digitalWrite(valvePowerPin, HIGH);
  Serial.println("Opening valve");
}

void closeValve() {
  digitalWrite(valvePowerPin, LOW);
  Serial.println("Closing valve");
}



bool homeButtonHit() {
  return (digitalRead(limitSwitchPin) == LOW);
}

void setup() {
  // put your setup code here, to run once:
  Serial.begin(9600);
  pinMode(limitSwitchPin, INPUT_PULLUP);
  stepperRound.setSpeed(7000);
  stepsToRotate = stepsBetweenVials * (bottlesFilled + 1);

  pinMode(miniPumpPin1, OUTPUT);
  pinMode(miniPumpPin2, OUTPUT);
  pinMode(actuatorPin1, OUTPUT);
  pinMode(actuatorPin2, OUTPUT);
  pinMode(valvePowerPin, OUTPUT);
  //pinMode(reservoirEmptyPin, INPUT);
  //pinMode(reservoirFullPin, INPUT);
  mainPump.setSpeed(1000);
  stopPump();
  //stopMainPump();
  retractActuator();
}

void loop() {
  // put your main code here, to run repeatedly:
  bottlesFilled =0;
  //actuatorStepperTest();
  //fillVialTest();
  //flushSystem();
  //drainReservoir();
  //digitalWrite(4, HIGH);
  //digitalWrite(6,LOW);
  fullTest();
  //filterFlush();
  //miniPumpControl();
  //pumpBackwards();
  //fullTest();
  // digitalWrite(11, HIGH);
  // delay(5000);
  // digitalWrite(11, LOW);
  // Serial.println("1");
  // delay(5000);
  //extendActuator();
}
