Motunrayo321/AquaBot/(commit log)

2024-06-20 mini pump code
2024-06-20 Added sequence test for both motors, made the control code based on the flow (missing functions, to turn into modules)
    [2.distributionSystemControl.ino]
2024-06-22 modified control code for servo mechanism
2024-06-23 unit tests for servo and stepper
2024-06-23 uses regular stepper library for simpler code
2024-06-24 started testing. Used normal stepper library
2024-06-25 modified combined tests to include relay and linear actuator
2024-06-30 New motor driver
2024-07-10 Ready for integration!
    Tested flushing and filter back wash code with big pump.
2024-07-11 Included 2 funtions to activate low power mode
2024-07-11 Added 2 funtions to activate low power mode
2024-07-11 new flushing code with new pump
2024-08-08 pcb file
    [5v_relay.kicad_sch, distribution_system.kicad_sch, dv8825.kicad_sch, flushing_system.kicad_sch, power_supply.kicad_sch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]
2024-08-29 cleaned up files
    [5v_relay.kicad_sch, distribution_system.kicad_sch, dv8825.kicad_sch, flushing_system.kicad_sch, power_supply.kicad_sch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]
2024-08-29 added main schematic
2024-08-29 pcb for high level prototype
    [5v_relay.kicad_sch, distribution_system.kicad_sch, dv8825.kicad_sch, flushing_system.kicad_sch, power_supply.kicad_sch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]
